JohnWallis01/MAX7000CPU-GEN2/Other/logo.dxf

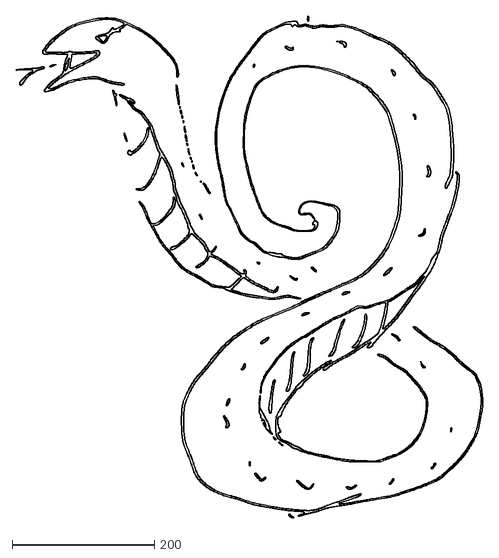
[picture p1: CAD file, 2021-08-25]
Other/logo.dxf
656.7 x 706.0
