JohnWallis01/MAX7000CPU-GEN2/(list of files, drawings)

Other design files:
MAX7000CPU-Gen2.dsn
MAX7000CPU-Gen2_autorouted.dsn
