JohnWallis01/MAX7000CPU-GEN2/MAX7000CPU-Gen2.kicad_pcb

## KiCad design MAX7000CPU-Gen2.kicad_pcb (2021-08-25)

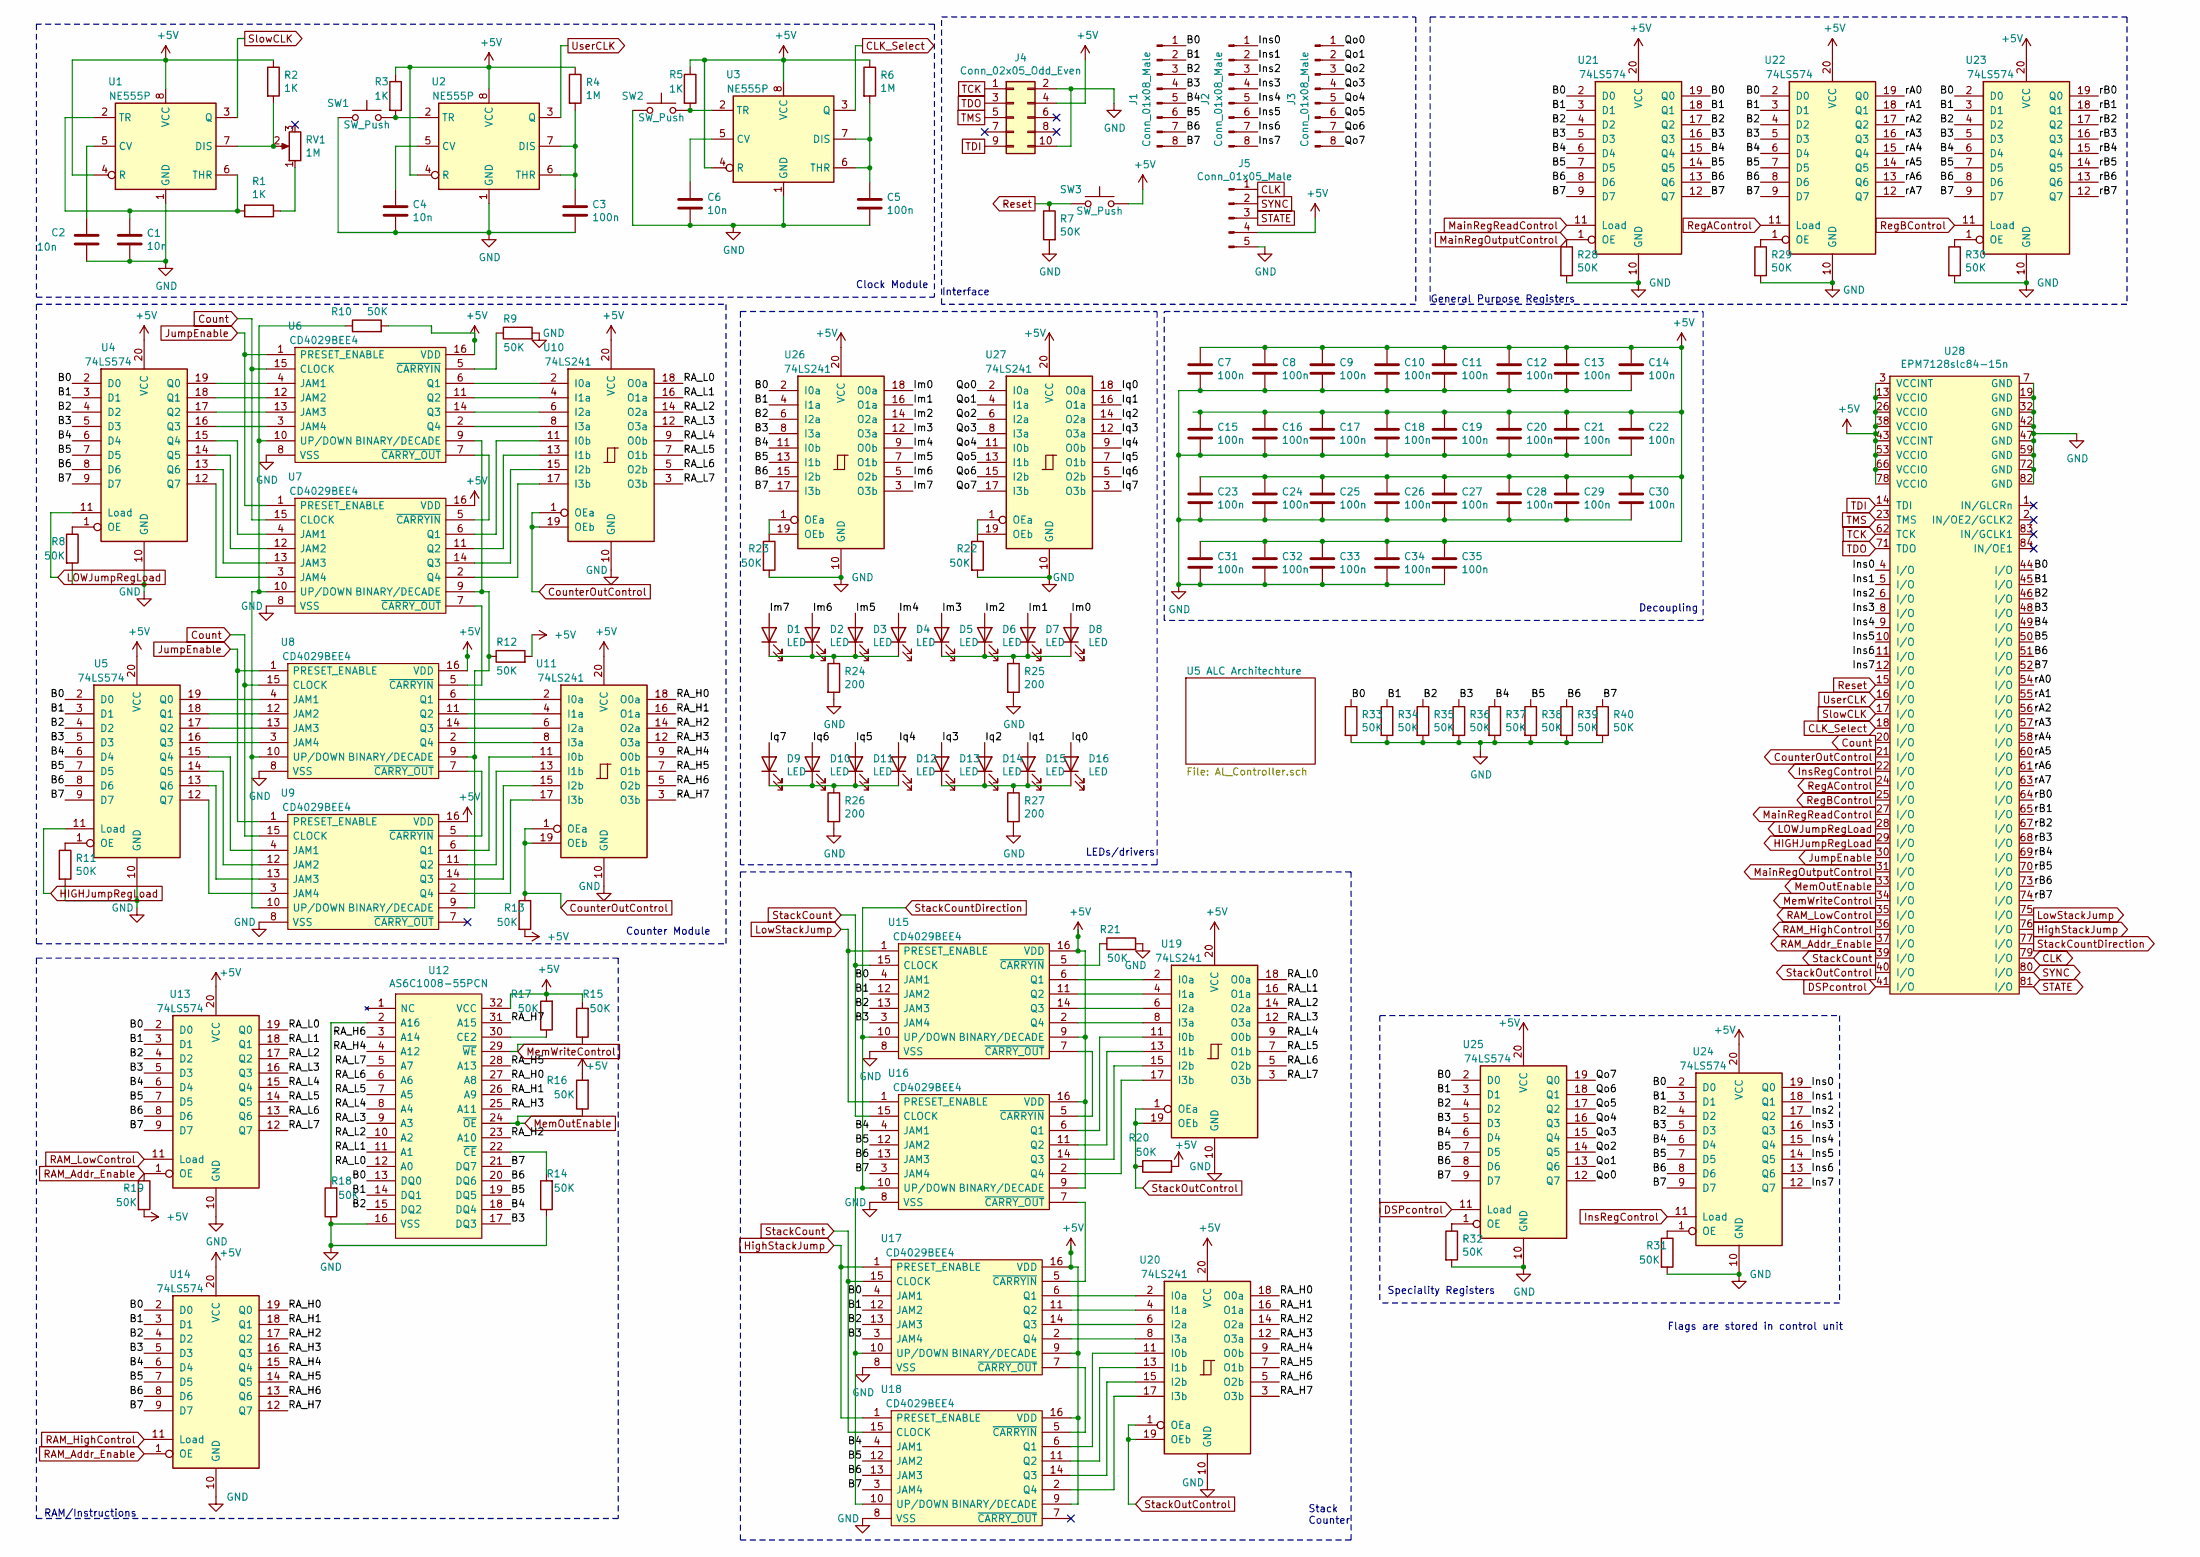
[picture p3: schematic MAX7000CPU-Gen2.sch]

Parts:
C1, C2, C4, C6: 10n; C_Disc_D5.0mm_W2.5mm_P2.50mm
C3, C5: 100n; C_Disc_D5.0mm_W2.5mm_P2.50mm
C7, C8, C9, C10, C11, C12, C13, C14, C15, C16, C17, C18, C19, C20, C21, C22, C23, C24, C25, C26, C27, C28, C29, C30, C31, C32, C33, C34, C35: 100n; C_0805_2012Metric_Pad1.18x1.45mm_HandSolder
D1, D2, D3, D4, D5, D6, D7, D8, D9, D10, D11, D12, D13, D14, D15, D16: LED; LED_D3.0mm
J1, J2, J3: Conn_01x08_Male; PinHeader_1x08_P2.54mm_Vertical
J4: Conn_02x05_Odd_Even; PinHeader_2x05_P2.54mm_Vertical
J5: Conn_01x05_Male; PinHeader_1x05_P2.54mm_Vertical
R1, R2, R3, R5: 1K; R_Axial_DIN0207_L6.3mm_D2.5mm_P7.62mm_Horizontal
R4, R6: 1M; R_Axial_DIN0207_L6.3mm_D2.5mm_P7.62mm_Horizontal
R7, R8, R9, R10, R11, R12, R13, R14, R15, R16, R17, R18, R19, R20, R21, R22, R23, R28, R29, R30, R31, R32, R33, R34, R35, R36, R37, R38, R39, R40: 50K; R_Axial_DIN0207_L6.3mm_D2.5mm_P7.62mm_Horizontal
R24, R25, R26, R27: 200; R_Axial_DIN0207_L6.3mm_D2.5mm_P7.62mm_Horizontal
RV1: 1M; SIP460W50P254L970H980Q3P
SW1, SW2, SW3: SW_Push; SW_PUSH_6mm
U1, U2, U3: NE555P; DIP-8_W7.62mm
U4, U5, U13, U14, U21, U22, U23, U24, U25: 74LS574; DIP-20_W7.62mm
U6, U7, U8, U9, U15, U16, U17, U18: CD4029BEE4; DIP-16_W7.62mm; Mouser Part Number 595-CD4029BEE4
U10, U11, U19, U20, U26, U27: 74LS241; DIP-20_W7.62mm
U12: AS6C1008-55PCN; DIP-32_W15.24mm; Mouser Part Number 913-AS6C1008-55PCN
U28: EPM7128slc84-15n; PLCC-84_THT-Socket

Connections:
+5V: C7.1, C8.1, C9.1, C10.1, C11.1, C12.1, C13.1, C14.1, C15.1, C16.1, C17.1, C18.1, C19.1, C20.1, C21.1, C22.1, C23.1, C24.1, C25.1, C26.1, C27.1, C28.1, C29.1, C30.1, C31.1, C32.1, C33.1, C34.1, C35.1, J4.4, J5.4, R2.1, R3.1, R4.1, R5.1, R6.1, R10.2, R12.2, R13.2, R15.2, R16.2, R17.2, R19.2, R20.2, SW3.2, U1.4 (R), U1.8 (VCC), U2.4 (R), U2.8 (VCC), U3.4 (R), U3.8 (VCC), U4.20 (VCC), U5.20 (VCC), U6.16 (VDD), U7.16 (VDD), U8.16 (VDD), U9.16 (VDD), U10.20 (VCC), U11.20 (VCC), U12.32 (VCC), U13.20 (VCC), U14.20 (VCC), U15.9 (BINARY/DECADE), U15.16 (VDD), U16.9 (BINARY/DECADE), U16.16 (VDD), U17.9 (BINARY/DECADE), U17.16 (VDD), U18.9 (BINARY/DECADE), U18.16 (VDD), U19.20 (VCC), U20.20 (VCC), U21.20 (VCC), U22.20 (VCC), U23.20 (VCC), U24.20 (VCC), U25.20 (VCC), U26.20 (VCC), U27.20 (VCC), U28.3 (VCCINT), U28.13 (VCCIO), U28.26 (VCCIO), U28.38 (VCCIO), U28.43 (VCCINT), U28.53 (VCCIO), U28.66 (VCCIO), U28.78 (VCCIO)
/B0: J1.1, R33.1, U4.2 (D0), U5.2 (D0), U12.13 (DQ0), U13.2 (D0), U14.2 (D0), U15.4 (JAM1), U17.4 (JAM1), U21.2 (D0), U21.19 (Q0), U22.2 (D0), U23.2 (D0), U24.2 (D0), U25.2 (D0), U26.2 (I0a), U28.44 (I/O)
/B1: J1.2, R34.1, U4.3 (D1), U5.3 (D1), U12.14 (DQ1), U13.3 (D1), U14.3 (D1), U15.12 (JAM2), U17.12 (JAM2), U21.3 (D1), U21.18 (Q1), U22.3 (D1), U23.3 (D1), U24.3 (D1), U25.3 (D1), U26.4 (I1a), U28.45 (I/O)
/B2: J1.3, R35.1, U4.4 (D2), U5.4 (D2), U12.15 (DQ2), U13.4 (D2), U14.4 (D2), U15.13 (JAM3), U17.13 (JAM3), U21.4 (D2), U21.17 (Q2), U22.4 (D2), U23.4 (D2), U24.4 (D2), U25.4 (D2), U26.6 (I2a), U28.46 (I/O)
/B3: J1.4, R36.1, U4.5 (D3), U5.5 (D3), U12.17 (DQ3), U13.5 (D3), U14.5 (D3), U15.3 (JAM4), U17.3 (JAM4), U21.5 (D3), U21.16 (Q3), U22.5 (D3), U23.5 (D3), U24.5 (D3), U25.5 (D3), U26.8 (I3a), U28.48 (I/O)
/B4: J1.5, R37.1, U4.6 (D4), U5.6 (D4), U12.18 (DQ4), U13.6 (D4), U14.6 (D4), U16.4 (JAM1), U18.4 (JAM1), U21.6 (D4), U21.15 (Q4), U22.6 (D4), U23.6 (D4), U24.6 (D4), U25.6 (D4), U26.11 (I0b), U28.49 (I/O)
/B5: J1.6, R38.1, U4.7 (D5), U5.7 (D5), U12.19 (DQ5), U13.7 (D5), U14.7 (D5), U16.12 (JAM2), U18.12 (JAM2), U21.7 (D5), U21.14 (Q5), U22.7 (D5), U23.7 (D5), U24.7 (D5), U25.7 (D5), U26.13 (I1b), U28.50 (I/O)
/B6: J1.7, R39.1, U4.8 (D6), U5.8 (D6), U12.20 (DQ6), U13.8 (D6), U14.8 (D6), U16.13 (JAM3), U18.13 (JAM3), U21.8 (D6), U21.13 (Q6), U22.8 (D6), U23.8 (D6), U24.8 (D6), U25.8 (D6), U26.15 (I2b), U28.51 (I/O)
/B7: J1.8, R40.1, U4.9 (D7), U5.9 (D7), U12.21 (DQ7), U13.9 (D7), U14.9 (D7), U16.3 (JAM4), U18.3 (JAM4), U21.9 (D7), U21.12 (Q7), U22.9 (D7), U23.9 (D7), U24.9 (D7), U25.9 (D7), U26.17 (I3b), U28.52 (I/O)
/Im0: D8.2 (A), U26.18 (O0a)
/Im1: D7.2 (A), U26.16 (O1a)
/Im2: D6.2 (A), U26.14 (O2a)
/Im3: D5.2 (A), U26.12 (O3a)
/Im4: D4.2 (A), U26.9 (O0b)
/Im5: D3.2 (A), U26.7 (O1b)
/Im6: D2.2 (A), U26.5 (O2b)
/Im7: D1.2 (A), U26.3 (O3b)
/Ins0: J2.1, U24.19 (Q0), U28.4 (I/O)
/Ins1: J2.2, U24.18 (Q1), U28.5 (I/O)
/Ins2: J2.3, U24.17 (Q2), U28.6 (I/O)
/Ins3: J2.4, U24.16 (Q3), U28.8 (I/O)
/Ins4: J2.5, U24.15 (Q4), U28.9 (I/O)
/Ins5: J2.6, U24.14 (Q5), U28.10 (I/O)
/Ins6: J2.7, U24.13 (Q6), U28.11 (I/O)
/Ins7: J2.8, U24.12 (Q7), U28.12 (I/O)
/Iq0: D16.2 (A), U27.18 (O0a)
/Iq1: D15.2 (A), U27.16 (O1a)
/Iq2: D14.2 (A), U27.14 (O2a)
/Iq3: D13.2 (A), U27.12 (O3a)
/Iq4: D12.2 (A), U27.9 (O0b)
/Iq5: D11.2 (A), U27.7 (O1b)
/Iq6: D10.2 (A), U27.5 (O2b)
/Iq7: D9.2 (A), U27.3 (O3b)
/Qo0: J3.1, U25.12 (Q7), U27.2 (I0a)
/Qo1: J3.2, U25.13 (Q6), U27.4 (I1a)
/Qo2: J3.3, U25.14 (Q5), U27.6 (I2a)
/Qo3: J3.4, U25.15 (Q4), U27.8 (I3a)
/Qo4: J3.5, U25.16 (Q3), U27.11 (I0b)
/Qo5: J3.6, U25.17 (Q2), U27.13 (I1b)
/Qo6: J3.7, U25.18 (Q1), U27.15 (I2b)
/Qo7: J3.8, U25.19 (Q0), U27.17 (I3b)
/RA_H0: U11.18 (O0a), U12.27 (A8), U14.19 (Q0), U20.18 (O0a)
/RA_H1: U11.16 (O1a), U12.26 (A9), U14.18 (Q1), U20.16 (O1a)
/RA_H2: U11.14 (O2a), U12.23 (A10), U14.17 (Q2), U20.14 (O2a)
/RA_H3: U11.12 (O3a), U12.25 (A11), U14.16 (Q3), U20.12 (O3a)
/RA_H4: U11.9 (O0b), U12.4 (A12), U14.15 (Q4), U20.9 (O0b)
/RA_H5: U11.7 (O1b), U12.28 (A13), U14.14 (Q5), U20.7 (O1b)
/RA_H6: U11.5 (O2b), U12.3 (A14), U14.13 (Q6), U20.5 (O2b)
/RA_H7: U11.3 (O3b), U12.31 (A15), U14.12 (Q7), U20.3 (O3b)
/RA_L0: U10.18 (O0a), U12.12 (A0), U13.19 (Q0), U19.18 (O0a)
/RA_L1: U10.16 (O1a), U12.11 (A1), U13.18 (Q1), U19.16 (O1a)
/RA_L2: U10.14 (O2a), U12.10 (A2), U13.17 (Q2), U19.14 (O2a)
/RA_L3: U10.12 (O3a), U12.9 (A3), U13.16 (Q3), U19.12 (O3a)
/RA_L4: U10.9 (O0b), U12.8 (A4), U13.15 (Q4), U19.9 (O0b)
/RA_L5: U10.7 (O1b), U12.7 (A5), U13.14 (Q5), U19.7 (O1b)
/RA_L6: U10.5 (O2b), U12.6 (A6), U13.13 (Q6), U19.5 (O2b)
/RA_L7: U10.3 (O3b), U12.5 (A7), U13.12 (Q7), U19.3 (O3b)
/rA0: U22.19 (Q0), U28.54 (I/O)
/rA1: U22.18 (Q1), U28.55 (I/O)
/rA2: U22.17 (Q2), U28.56 (I/O)
/rA3: U22.16 (Q3), U28.57 (I/O)
/rA4: U22.15 (Q4), U28.58 (I/O)
/rA5: U22.14 (Q5), U28.60 (I/O)
/rA6: U22.13 (Q6), U28.61 (I/O)
/rA7: U22.12 (Q7), U28.63 (I/O)
/rB0: U23.19 (Q0), U28.64 (I/O)
/rB1: U23.18 (Q1), U28.65 (I/O)
/rB2: U23.17 (Q2), U28.67 (I/O)
/rB3: U23.16 (Q3), U28.68 (I/O)
/rB4: U23.15 (Q4), U28.69 (I/O)
/rB5: U23.14 (Q5), U28.70 (I/O)
/rB6: U23.13 (Q6), U28.73 (I/O)
/rB7: U23.12 (Q7), U28.74 (I/O)
CLK: J5.1, U28.79 (I/O)
CLK_Select: U3.3 (Q), U28.18 (I/O)
Count: U6.15 (CLOCK), U7.15 (CLOCK), U8.15 (CLOCK), U9.15 (CLOCK), U28.20 (I/O)
CounterOutControl: R13.1, U10.1 (OEa), U10.19 (OEb), U11.1 (OEa), U11.19 (OEb), U28.21 (I/O)
DSPcontrol: U25.11 (Load), U28.41 (I/O)
GND: C1.2, C2.2, C3.2, C4.2, C5.2, C6.2, C7.2, C8.2, C9.2, C10.2, C11.2, C12.2, C13.2, C14.2, C15.2, C16.2, C17.2, C18.2, C19.2, C20.2, C21.2, C22.2, C23.2, C24.2, C25.2, C26.2, C27.2, C28.2, C29.2, C30.2, C31.2, C32.2, C33.2, C34.2, C35.2, J4.2, J4.10, J5.5, R7.2, R8.2, R9.2, R11.2, R14.1, R18.1, R21.2, R22.2, R23.2, R24.2, R25.2, R26.2, R27.2, R28.2, R29.2, R30.2, R31.2, R32.2, R33.2, R34.2, R35.2, R36.2, R37.2, R38.2, R39.2, R40.2, SW1.1, SW2.1, U1.1 (GND), U2.1 (GND), U3.1 (GND), U4.10 (GND), U5.10 (GND), U6.8 (VSS), U7.8 (VSS), U8.8 (VSS), U9.8 (VSS), U10.10 (GND), U11.10 (GND), U12.16 (VSS), U13.10 (GND), U14.10 (GND), U15.8 (VSS), U16.8 (VSS), U17.8 (VSS), U18.8 (VSS), U19.10 (GND), U20.10 (GND), U21.10 (GND), U22.10 (GND), U23.10 (GND), U24.10 (GND), U25.10 (GND), U26.10 (GND), U27.10 (GND), U28.7 (GND), U28.19 (GND), U28.32 (GND), U28.42 (GND), U28.47 (GND), U28.59 (GND), U28.72 (GND), U28.82 (GND)
HIGHJumpRegLoad: U5.11 (Load), U28.29 (I/O)
HighStackJump: U17.1 (PRESET_ENABLE), U18.1 (PRESET_ENABLE), U28.76 (I/O)
InsRegControl: U24.11 (Load), U28.22 (I/O)
JumpEnable: U6.1 (PRESET_ENABLE), U7.1 (PRESET_ENABLE), U8.1 (PRESET_ENABLE), U9.1 (PRESET_ENABLE), U28.30 (I/O)
LOWJumpRegLoad: U4.11 (Load), U28.28 (I/O)
LowStackJump: U15.1 (PRESET_ENABLE), U16.1 (PRESET_ENABLE), U28.75 (I/O)
MainRegOutputControl: R28.1, U21.1 (OE), U28.31 (I/O)
MainRegReadControl: U21.11 (Load), U28.27 (I/O)
MemOutEnable: R16.1, U12.24 (~OE), U28.33 (I/O)
MemWriteControl: R15.1, U12.29 (~WE), U28.34 (I/O)
unnamed: C1.1, R1.2, U1.2 (TR), U1.6 (THR)
unnamed: C2.1, U1.5 (CV)
unnamed: C3.1, R4.2, U2.6 (THR), U2.7 (DIS)
unnamed: C4.1, U2.5 (CV)
unnamed: C5.1, R6.2, U3.6 (THR), U3.7 (DIS)
unnamed: C6.1, U3.5 (CV)
unnamed: D1.1 (K), D2.1 (K), D3.1 (K), D4.1 (K), R24.1
unnamed: D5.1 (K), D6.1 (K), D7.1 (K), D8.1 (K), R25.1
unnamed: D9.1 (K), D10.1 (K), D11.1 (K), D12.1 (K), R26.1
unnamed: D13.1 (K), D14.1 (K), D15.1 (K), D16.1 (K), R27.1
unnamed: R1.1, RV1.1
unnamed: R2.2, RV1.2, U1.7 (DIS)
unnamed: R3.2, SW1.2, U2.2 (TR)
unnamed: R5.2, SW2.2, U3.2 (TR)
unnamed: R8.1, U4.1 (OE)
unnamed: R9.1, U6.5 (~CARRYIN)
unnamed: R10.1, U6.10 (UP/DOWN), U7.10 (UP/DOWN), U8.10 (UP/DOWN), U9.10 (UP/DOWN)
unnamed: R11.1, U5.1 (OE)
unnamed: R12.1, U6.9 (BINARY/DECADE), U7.9 (BINARY/DECADE), U8.9 (BINARY/DECADE), U9.9 (BINARY/DECADE)
unnamed: R14.2, U12.22 (~CE)
unnamed: R17.1, U12.30 (CE2)
unnamed: R18.2, U12.2 (A16)
unnamed: R21.1, U15.5 (~CARRYIN)
unnamed: R22.1, U27.1 (OEa), U27.19 (OEb)
unnamed: R23.1, U26.1 (OEa), U26.19 (OEb)
unnamed: R29.1, U22.1 (OE)
unnamed: R30.1, U23.1 (OE)
unnamed: R31.1, U24.1 (OE)
unnamed: R32.1, U25.1 (OE)
unnamed: U4.12 (Q7), U7.3 (JAM4)
unnamed: U4.13 (Q6), U7.13 (JAM3)
unnamed: U4.14 (Q5), U7.12 (JAM2)
unnamed: U4.15 (Q4), U7.4 (JAM1)
unnamed: U4.16 (Q3), U6.3 (JAM4)
unnamed: U4.17 (Q2), U6.13 (JAM3)
unnamed: U4.18 (Q1), U6.12 (JAM2)
unnamed: U4.19 (Q0), U6.4 (JAM1)
unnamed: U5.12 (Q7), U9.3 (JAM4)
unnamed: U5.13 (Q6), U9.13 (JAM3)
unnamed: U5.14 (Q5), U9.12 (JAM2)
unnamed: U5.15 (Q4), U9.4 (JAM1)
unnamed: U5.16 (Q3), U8.3 (JAM4)
unnamed: U5.17 (Q2), U8.13 (JAM3)
unnamed: U5.18 (Q1), U8.12 (JAM2)
unnamed: U5.19 (Q0), U8.4 (JAM1)
unnamed: U6.7 (~CARRY_OUT), U7.5 (~CARRYIN)
unnamed: U7.7 (~CARRY_OUT), U8.5 (~CARRYIN)
unnamed: U8.7 (~CARRY_OUT), U9.5 (~CARRYIN)
unnamed: U6.6 (Q1), U10.2 (I0a)
unnamed: U6.11 (Q2), U10.4 (I1a)
unnamed: U6.14 (Q3), U10.6 (I2a)
unnamed: U6.2 (Q4), U10.8 (I3a)
unnamed: U7.6 (Q1), U10.11 (I0b)
unnamed: U7.11 (Q2), U10.13 (I1b)
unnamed: U7.14 (Q3), U10.15 (I2b)
unnamed: U7.2 (Q4), U10.17 (I3b)
unnamed: U8.6 (Q1), U11.2 (I0a)
unnamed: U8.11 (Q2), U11.4 (I1a)
unnamed: U8.14 (Q3), U11.6 (I2a)
unnamed: U8.2 (Q4), U11.8 (I3a)
unnamed: U9.6 (Q1), U11.11 (I0b)
unnamed: U9.11 (Q2), U11.13 (I1b)
unnamed: U9.14 (Q3), U11.15 (I2b)
unnamed: U9.2 (Q4), U11.17 (I3b)
unnamed: U15.2 (Q4), U19.8 (I3a)
unnamed: U15.6 (Q1), U19.2 (I0a)
unnamed: U15.7 (~CARRY_OUT), U16.5 (~CARRYIN)
unnamed: U15.11 (Q2), U19.4 (I1a)
unnamed: U15.14 (Q3), U19.6 (I2a)
unnamed: U16.2 (Q4), U19.17 (I3b)
unnamed: U16.6 (Q1), U19.11 (I0b)
unnamed: U16.7 (~CARRY_OUT), U17.5 (~CARRYIN)
unnamed: U16.11 (Q2), U19.13 (I1b)
unnamed: U16.14 (Q3), U19.15 (I2b)
unnamed: U17.2 (Q4), U20.8 (I3a)
unnamed: U17.6 (Q1), U20.2 (I0a)
unnamed: U17.7 (~CARRY_OUT), U18.5 (~CARRYIN)
unnamed: U17.11 (Q2), U20.4 (I1a)
unnamed: U17.14 (Q3), U20.6 (I2a)
unnamed: U18.2 (Q4), U20.17 (I3b)
unnamed: U18.6 (Q1), U20.11 (I0b)
unnamed: U18.11 (Q2), U20.13 (I1b)
unnamed: U18.14 (Q3), U20.15 (I2b)
RAM_Addr_Enable: R19.1, U13.1 (OE), U14.1 (OE), U28.37 (I/O)
RAM_HighControl: U14.11 (Load), U28.36 (I/O)
RAM_LowControl: U13.11 (Load), U28.35 (I/O)
RegAControl: U22.11 (Load), U28.24 (I/O)
RegBControl: U23.11 (Load), U28.25 (I/O)
Reset: R7.1, SW3.1, U28.15 (I/O)
STATE: J5.3, U28.81 (I/O)
SYNC: J5.2, U28.80 (I/O)
SlowCLK: U1.3 (Q), U28.17 (I/O)
StackCount: U15.15 (CLOCK), U16.15 (CLOCK), U17.15 (CLOCK), U18.15 (CLOCK), U28.39 (I/O)
StackCountDirection: U15.10 (UP/DOWN), U16.10 (UP/DOWN), U17.10 (UP/DOWN), U18.10 (UP/DOWN), U28.77 (I/O)
StackOutControl: R20.1, U19.1 (OEa), U19.19 (OEb), U20.1 (OEa), U20.19 (OEb), U28.40 (I/O)
TCK: J4.1, U28.62 (TCK)
TDI: J4.9, U28.14 (TDI)
TDO: J4.3, U28.71 (TDO)
TMS: J4.5, U28.23 (TMS)
UserCLK: U2.3 (Q), U28.16 (I/O)

Notes on the sheet:
Clock Module
Counter Module
LEDs/drivers
General Purpose Registers
Interface
RAM/Instructions
Stack Counter
Speciality Registers
Flags are stored in control unit
Decoupling

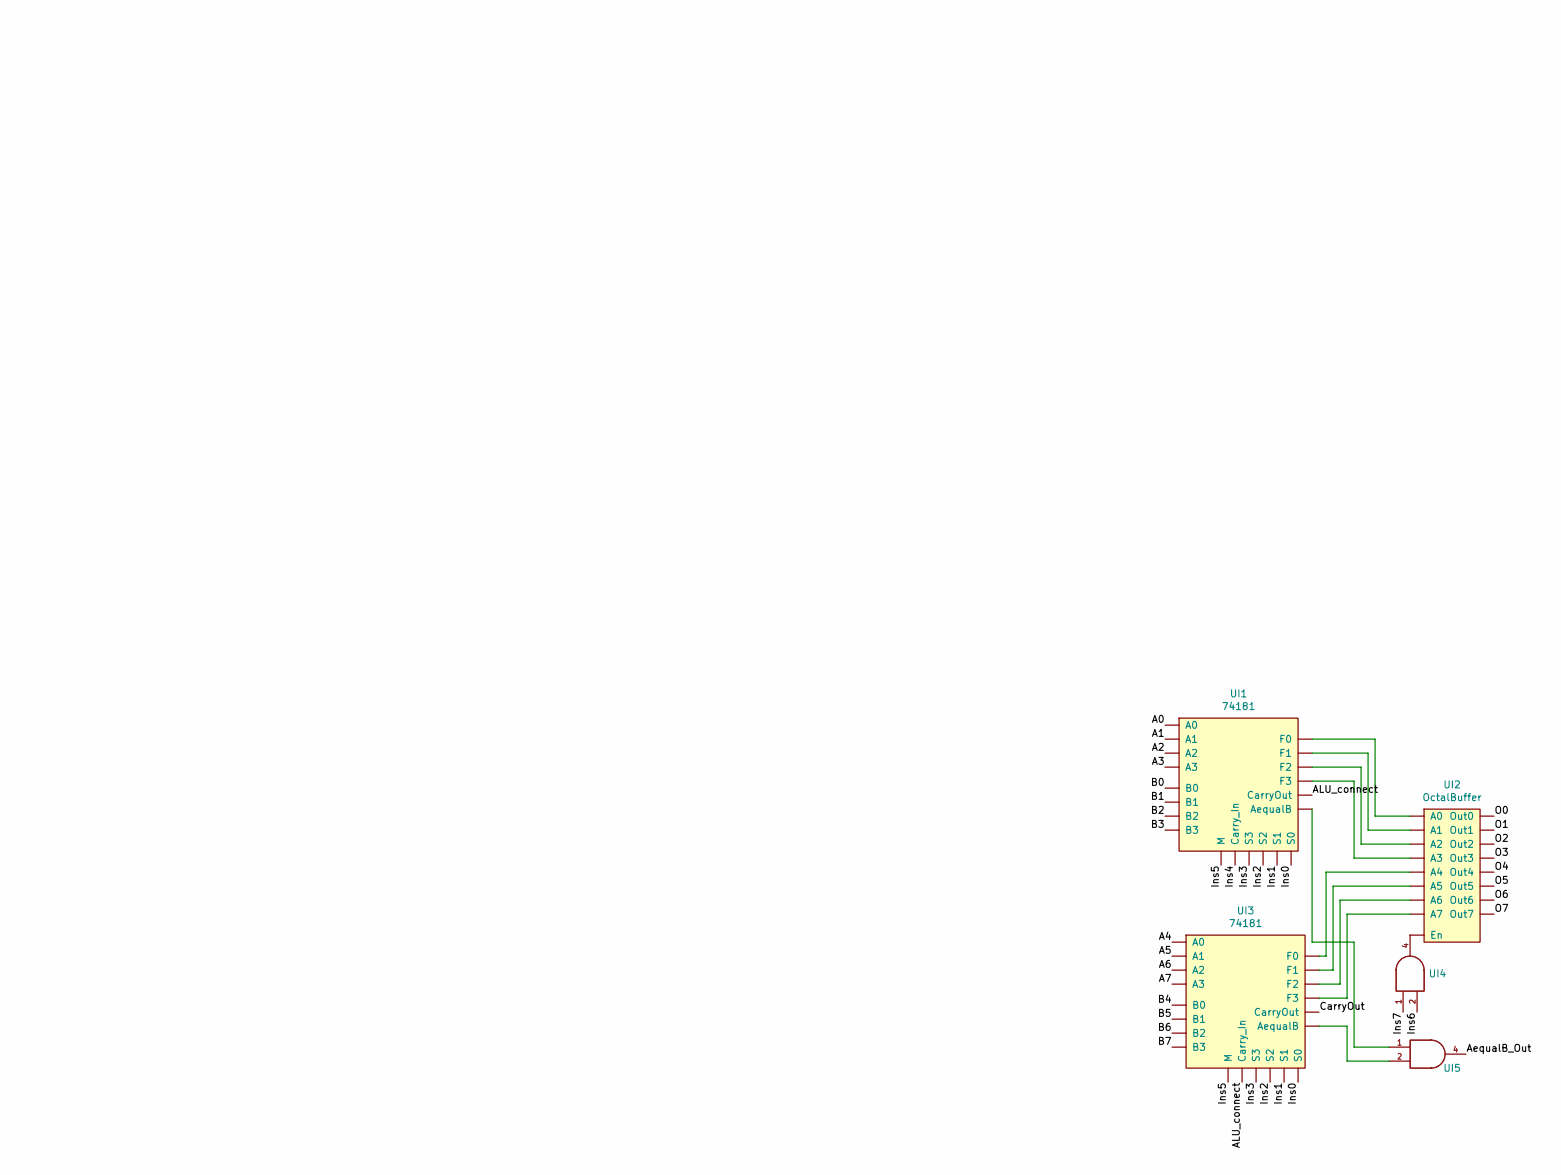
[picture p4: schematic AL_Controller.sch, part in row 2, column 2]

Parts:
UI1, UI3: 74181
UI2: OctalBuffer
UI4: 74AHC1G08
UI5: a

Connections:
unnamed: UI1.~, UI2.~, UI3.~, UI5.1
unnamed: UI2.~, UI3.~, UI4.4
unnamed: UI3.~, UI5.2

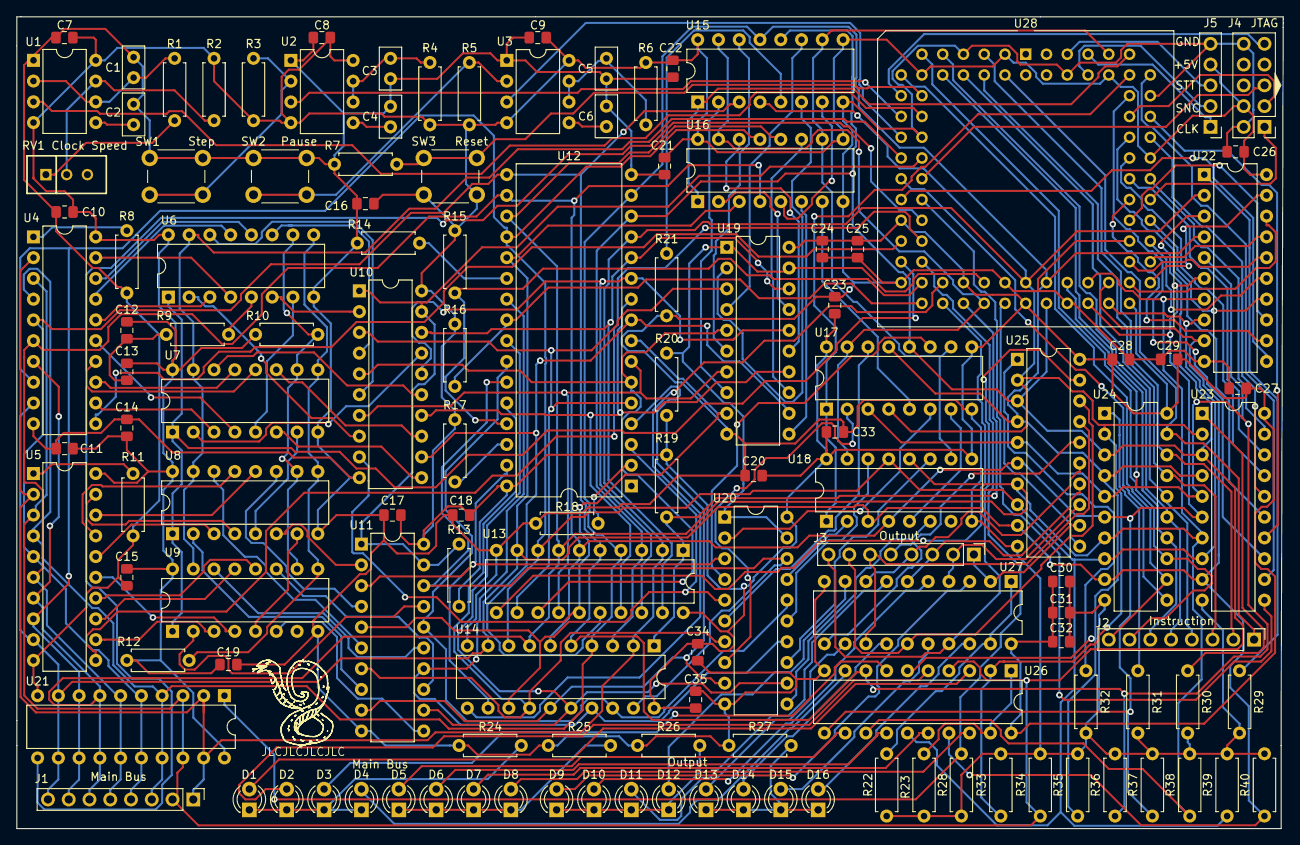
[picture p5: board MAX7000CPU-Gen2.kicad_pcb from above]

Board: 2 copper layers, 154.9 x 99.3 mm, 128 parts (0 on the bottom side), 189 nets.
