JohnWallis01/MAX7000CPU-GEN2/Other/out.vhdl

if Instruction = "10111111" and Q0 = '0' and Q1 = '0' and Q2 = '0' and CarryFlag = 'X' and ABFlag = 'X' then
                  Count <= 1
                  CounterOutControl <= '0';
                  InsRegControl <= '0';
                  RegAControl <= '0';
                  RegBControl <= '0';
                  MainRegReadControl <= '0';
                  LowJumpRegLoad <= '0';
                  HighJumpRegLoad <= '0';
                  JumpEnable <= '0';
                  MainRegOutputControl <= '1';
                  MemOutEnable <= '1';
                  MemWriteControl <= '1';
                  Ram_LowControl <= '0';
                  Ram_HighControl <= '0';
                  Ram_Addr_Enable <='1';
                  StackCount <= '0';
                  StackOutControl <= '1';
                  DisplayControl <='0';
                  LowStackJump <='0';
                  HighStackJump <= '0';
                  StackCountDirection <='0';

 elsif Instruction = "10111111" and Q0 = '1' and Q1 = '0' and Q2 = '0' and CarryFlag = 'X' and ABFlag = 'X' then
                  Count <= 0
                  CounterOutControl <= '1';
                  InsRegControl <= '0';
                  RegAControl <= '0';
                  RegBControl <= '0';
                  MainRegReadControl <= '0';
                  LowJumpRegLoad <= '0';
                  HighJumpRegLoad <= '0';
                  JumpEnable <= '0';
                  MainRegOutputControl <= '1';
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
                  Ram_Addr_Enable <='1';
                  StackCount <= '0';
                  StackOutControl <= '1';
                  DisplayControl <='0';
                  LowStackJump <='0';
                  HighStackJump <= '1';
                  StackCountDirection <='1';

 elsif Instruction = "10100100" and Q0 = '1' and Q1 = '1' and Q2 = '1' and CarryFlag = 'X' and ABFlag = 'X' then
                  Count <= 0
                  CounterOutControl <= '0';
                  InsRegControl <= '0';
                  RegAControl <= '0';
                  RegBControl <= '0';
                  MainRegReadControl <= '0';
                  LowJumpRegLoad <= '0';
                  HighJumpRegLoad <= '0';
                  JumpEnable <= '0';
                  MainRegOutputControl <= '1';
                  MemOutEnable <= '0';
                  MemWriteControl <= '1';
                  Ram_LowControl <= '0';
                  Ram_HighControl <= '0';
                  Ram_Addr_Enable <='1';
                  StackCount <= '0';
                  StackOutControl <= '1';
                  DisplayControl <='0';
                  LowStackJump <='0';
                  HighStackJump <= '1';
                  StackCountDirection <='1';
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
