JohnWallis01/MAX7000CPU-GEN2/Quartus/MAX7000CPU_ALC/VHDL files/logic.vhdl

-- --basic logic components of the ALU
-- library ieee;
-- use ieee.std_logic_1164.all;
--
-- entity INV is
--   port (A: in std_logic;
--   F: out std_logic);
-- end INV;
--
-- architecture INV_beh of INV is
-- begin
--     F <= not A;
-- end architecture;
--
-- library ieee;
-- use ieee.std_logic_1164.all;
--
-- entity dual_AND is
--   port (A: in std_logic;
--   B: in std_logic;
--   F: out std_logic);
-- end dual_AND;
--
-- architecture dual_AND_beh of dual_AND is
-- begin
--     F <= A and B;
-- end architecture;
--
-- library ieee;
-- use ieee.std_logic_1164.all;
--
-- entity triple_AND is
--   port (A: in std_logic;
--   B: in std_logic;
--   C: in std_logic;
--   F: out std_logic);
-- end triple_AND;
--
-- architecture triple_AND_beh of triple_AND is
-- begin
--     F <= A and B and C;
-- end architecture;
--
-- library ieee;
-- use ieee.std_logic_1164.all;
--
-- entity quad_AND is
--   port (A: in std_logic;
--   B: in std_logic;
--   C: in std_logic;
--   D: in std_logic;
--   F: out std_logic);
-- end quad_AND;
--
-- architecture quad_AND_beh of quad_AND is
-- begin
--     F <= A and B and C and D;
-- end architecture;
--
-- library ieee;
-- use ieee.std_logic_1164.all;
--
-- entity pent_AND is
--   port (A: in std_logic;
--   B: in std_logic;
--   C: in std_logic;
--   D: in std_logic;
--   E: in std_logic;
--   F: out std_logic);
-- end pent_AND;
--
-- architecture pent_AND_beh of pent_AND is
-- begin
--     F <= A and B and C and D and E;
-- end architecture;
--
-- library ieee;
-- use ieee.std_logic_1164.all;
--
-- entity dual_XOR is
--   port(A: in std_logic;
--   B: in std_logic;
--   F: out std_logic);
-- end dual_XOR;
--
-- architecture dual_XOR_beh of dual_XOR is
-- begin
--   F <= A xor B;
-- end architecture;
--
-- library ieee;
-- use ieee.std_logic_1164.all;
--
-- entity dual_NOR is
--   port(A: in std_logic;
--   B: in std_logic;
--   F: out std_logic);
-- end dual_NOR;
--
-- architecture dual_NOR_beh of dual_NOR is
-- begin
--   F <= A nor B;
-- end architecture;
--
-- library ieee;
-- use ieee.std_logic_1164.all;
--
-- entity triple_NOR is
--   port(A: in std_logic;
--   B: in std_logic;
--   C: in std_logic;
--   F: out std_logic);
-- end triple_NOR;
--
-- architecture triple_NOR_beh of triple_NOR is
-- begin
--   F <= ((not A) and (not B) and (not C));
-- end architecture;
--
-- library ieee;
-- use ieee.std_logic_1164.all;
--
-- entity quad_NOR is
--   port(A: in std_logic;
--   B: in std_logic;
--   C: in std_logic;
--   D: in std_logic;
--   F: out std_logic);
-- end quad_NOR;
--
-- architecture quad_NOR_beh of quad_NOR is
-- begin
--   F <= ((not A) and (not B) and (not C) and (not D));
-- end architecture;
--
--
-- library ieee;
-- use ieee.std_logic_1164.all;
--
-- entity quad_OR is
--   port(A: in std_logic;
--   B: in std_logic;
--   C: in std_logic;
--   D: in std_logic;
--   F: out std_logic);
-- end quad_OR;
--
-- architecture quad_OR_beh of quad_OR is
-- begin
--   F <= A or B or C or D;
-- end architecture;
--
--
-- library ieee;
-- use ieee.std_logic_1164.all;
--
-- entity BUF is
--   port(A: in std_logic;
--   F: out std_logic);
-- end BUF;
--
-- architecture BUF_beh of BUF is
-- begin
--   F <= A;
-- end architecture;
--
--
-- library ieee;
-- use ieee.std_logic_1164.all;
--
-- entity dual_NAND is
--   port (A: in std_logic;
--   B: in std_logic;
--   F: out std_logic);
-- end dual_NAND;
--
-- architecture dual_NAND_beh of dual_NAND is
-- begin
--     F <= not (A and B);
-- end architecture;


library ieee;
use ieee.std_logic_1164.all;
entity Octal_Bus_Driver is
  port(
  A: In std_logic_vector (7 downto 0);
  O: Out std_logic_vector (7 downto 0);
  En: In std_logic
  );

end Octal_Bus_Driver;

architecture Octal_Bus_Driver_beh of Octal_Bus_Driver is
begin
    O <= A when En='1' else "ZZZZZZZZ";
end architecture;


library ieee;
use ieee.std_logic_1164.all;

entity D_flip_flop is
   port (clk,Din,rst,en : in std_logic;
            Q: out std_logic;
            Qnot : out std_logic);
 end D_flip_flop;
architecture DFF_arch of D_flip_flop is
   begin
       process (clk,en,Din,rst)
        begin
             if(en='0') then
               Q <='Z';
               Qnot <= 'Z';
             elsif(rst='1') then
               Q <='0';
               Qnot <='1';
             elsif(clk'event and clk='1') then
               Q <= Din;
               Qnot <= not Din;
             end  if;
     end process;
end DFF_arch;


library IEEE;
use IEEE.STD_LOGIC_1164.ALL;
use IEEE.STD_LOGIC_UNSIGNED.ALL;

entity undecal_shift_register is
    Port ( D   : in  std_logic;
           CLK : in  std_logic;
           Q : out std_logic_vector (10 downto 0));
end undecal_shift_register;

architecture shift_register_beh of undecal_shift_register is
    signal shift_reg : std_logic_vector(10 downto 0);
begin


    -- shift register
    process (CLK)
    begin
        if (CLK'event and CLK = '1') then
            shift_reg(9 downto 0) <= shift_reg(10 downto 1);
            shift_reg(10) <= D;
        end if;
    end process;

    Q <= shift_reg;

end shift_register_beh;
