JohnWallis01/MAX7000CPU-GEN2/(commit log)

2021-07-21 Inital Commit
    [AL_Controller.sch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]
2021-08-15 Forked from GEN1
    [AL_Controller.sch, MAX7000CPU-Gen2.kicad_pcb, MAX7000CPU-Gen2.sch]
2021-08-17 CD4029 respin
    [MAX7000CPU-Gen2.sch]
2021-08-17 Respin Counter
    [AL_Controller.sch, MAX7000CPU-Gen2.sch]
2021-08-17 Stack Implementation
    [AL_Controller.sch, MAX7000CPU-Gen2.sch]
2021-08-17 Footprint Association
    [MAX7000CPU-Gen2.kicad_pcb, MAX7000CPU-Gen2.sch]
2021-08-18 Counter Layout
    [AL_Controller.sch, MAX7000CPU-Gen2.kicad_pcb, MAX7000CPU-Gen2.sch]
2021-08-18 PCB component placements
    [MAX7000CPU-Gen2.kicad_pcb, MAX7000CPU-Gen2.sch]
2021-08-19 all parts laid out
    [MAX7000CPU-Gen2.kicad_pcb]
2021-08-19 silk screening - clock module
    [MAX7000CPU-Gen2.kicad_pcb, MAX7000CPU-Gen2.sch]
2021-08-23 silkscreening and 3d models implemented
    [MAX7000CPU-Gen2.kicad_pcb, MAX7000CPU-Gen2.sch]
2021-08-24 traces routed
    [MAX7000CPU-Gen2.kicad_pcb]
2021-08-24 first pass from the autorouter
    [MAX7000CPU-Gen2.kicad_pcb]
2021-08-24 optimising traces
    [MAX7000CPU-Gen2.kicad_pcb]
2021-08-25 finalized prodcution files
    [MAX7000CPU-Gen2.kicad_pcb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]
2021-08-25 cleaned repository
    [MAX7000CPU-Gen2-B_Cu.gbr, MAX7000CPU-Gen2-B_Mask.gbr, MAX7000CPU-Gen2-B_SilkS.gbr, MAX7000CPU-Gen2-Edge_Cuts.gbr, MAX7000CPU-Gen2-F_Cu.gbr, MAX7000CPU-Gen2-F_Mask.gbr, MAX7000CPU-Gen2-F_SilkS.gbr, MAX7000CPU-Gen2-drl_map.gbr]
2021-08-25 more cleaning
    [MAX7000CPU-Gen2.kicad_pcb]
2021-08-27 ksim production
    [AL_Controller.sch]
2021-08-31 controller timing
    [AL_Controller.sch, MAX7000CPU-Gen2.sch]
2021-09-04 other changes
    [AL_Controller.sch]
2021-09-26 pin assignments
2021-09-28 bec broke the ALU
    [ALC.vhdl, logic.vhdl]
2021-10-02 Mico Code Gen Overhaul
    [CPU MicroCode Signals.csv, CPU MicroCode Signals.xlsx]
2021-10-12 Basic Jumps Working + RepoCleaning
    [MAX7000CPU-Gen2.sch]
2021-10-29 Arduino Upload Sequence
2021-10-31 Stack Controller Added - Hardware is done (sort of)
    [CPU MicroCode Signals.csv, CPU MicroCode Signals.xlsx]
2021-10-31 CPU Microcode signals update
    [CPU MicroCode Signals.xlsx]
2021-11-01 Patching the Stack
    [CPU MicroCode Signals.xlsx]
2022-02-15 Added Keyboard Support in Firmware
    [CPU MicroCode Signals.xlsx]
2022-02-20 quick documentation update
    [CPU MicroCode Signals.xlsx]
